Edderic/air-cleaners/laminair/diy/diy.md

# DIY Installation

## Printing Steps

### General Settings

| | MK4 | MK3S+ |
| - | - | - |
|**Print Settings**| 0.20mm STRUCTURAL | 0.30 mm DRAFT mode |
|**Filament**| Generic PETG | Generic PETG |
|**Printer**| Original Prusa MK4 Input Shaper 0.4 nozzle | Original Prusa i3 MK3S & MK3S+ |
|**Supports**| None | None |

### STL information

| Link to file | Infill |
| - | - |
| [top_left.stl](../stl_files/top_left.stl)| 25% |
| [top_right.stl](../stl_files/top_right.stl)| 25% |
| [bottom_left.stl](../stl_files/bottom_left.stl)| 25% |
| [bottom_right.stl](../stl_files/bottom_right.stl)| 25% |
| [elbow.stl](../stl_files/elbow.stl)| 25% |
| [stand.stl](../stl_files/stand.stl)| 50% |
| [power_switch.stl](../stl_files/power_switch.stl)| 25% |

## Assembly Steps

- [Assembling the main body](./assembling-main-body.md)
- [Installing the handle](./installing-the-handle.md)
- [Installing the fans and the swivel](./installing-fans-and-swivel.md)
- [Installing the power bank](./installing-power-bank.md)
- [Installing the stand](./installing-stand.md)
- [Installing the filters](./installing-filters.md)
