Edderic/air-cleaners/common/shoulder_strap_half_ring.3mf

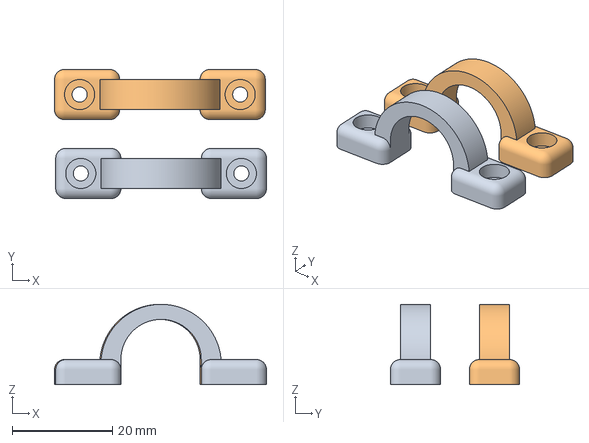
[picture p1: CAD file, 2023-08-09]
common/shoulder_strap_half_ring.3mf
42.2 x 25.7 x 16.0 mm
shoulder_strap_half_ring.stl x 2
