Edderic/air-cleaners/cr_boxes/handle.3mf

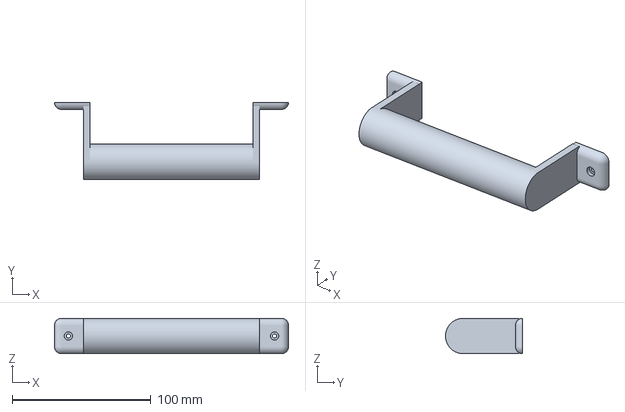
[picture p2: CAD file, 2023-10-18]
cr_boxes/handle.3mf
168.4 x 55.4 x 25.4 mm
