Edderic/air-cleaners/cr_boxes/three_by_three/bottom_right.3mf

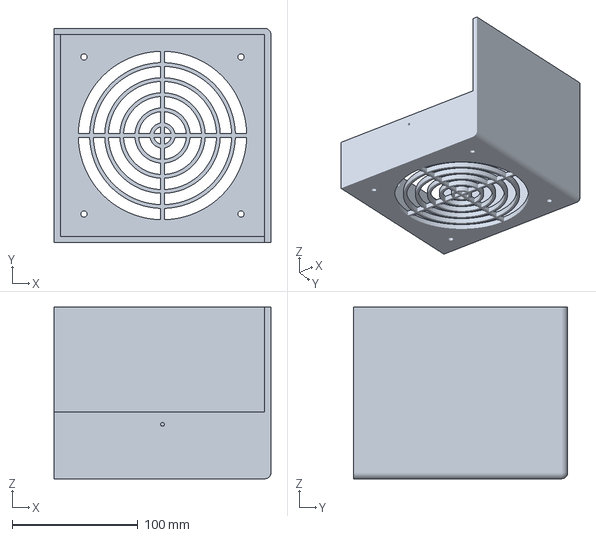
[picture p3: CAD file, 2023-10-16]
cr_boxes/three_by_three/bottom_right.3mf
172.7 x 170.6 x 136.5 mm
