Edderic/air-cleaners/laminair/3mf_files/top_right.3mf

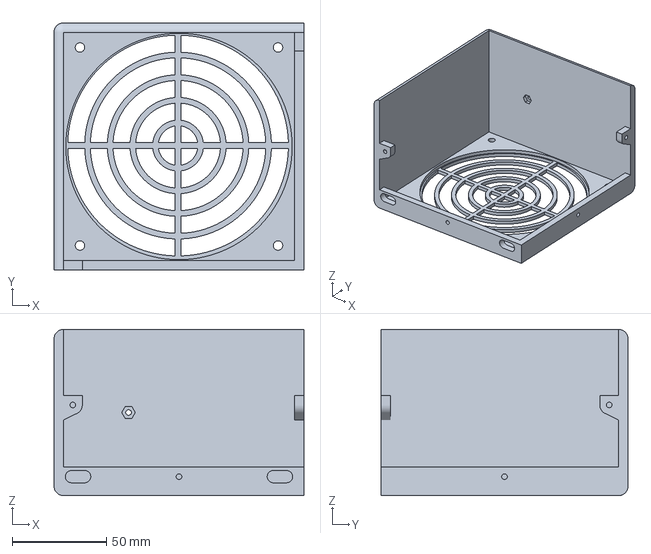
[picture p4: CAD file, 2024-10-20]
laminair/3mf_files/top_right.3mf
132.5 x 131.0 x 88.0 mm
