Edderic/air-cleaners/misc/probe_stand.3mf

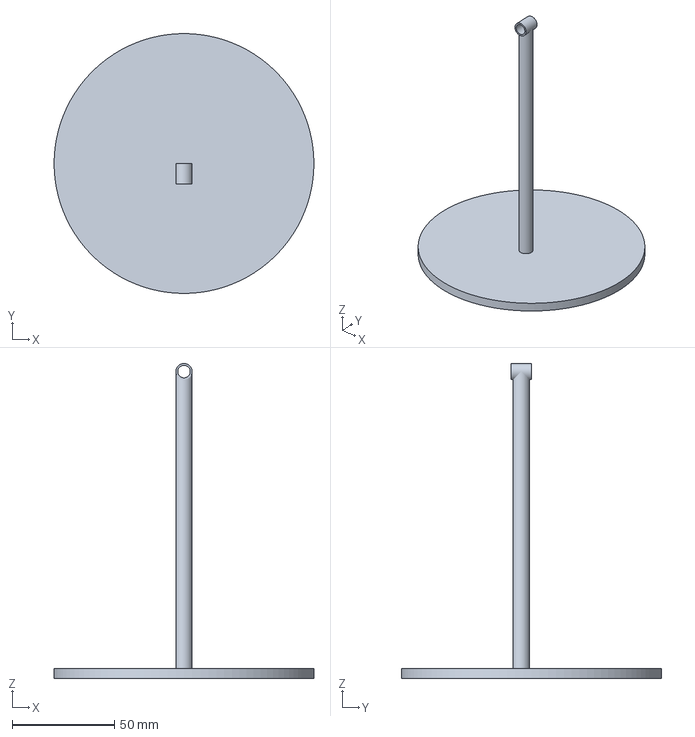
[picture p5: CAD file, 2024-10-07]
misc/probe_stand.3mf
127.0 x 127.0 x 154.0 mm
