Edderic/air-cleaners/cr_boxes/corners.3mf

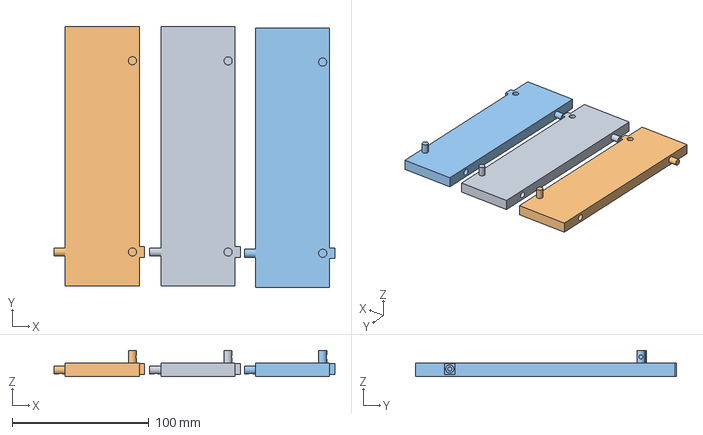
[picture p6: CAD file, 2023-10-07]
cr_boxes/corners.3mf
205.7 x 191.0 x 19.1 mm
corner.stl x 3
