Edderic/air-cleaners/misc/sps30_holder_with_wedge.3mf

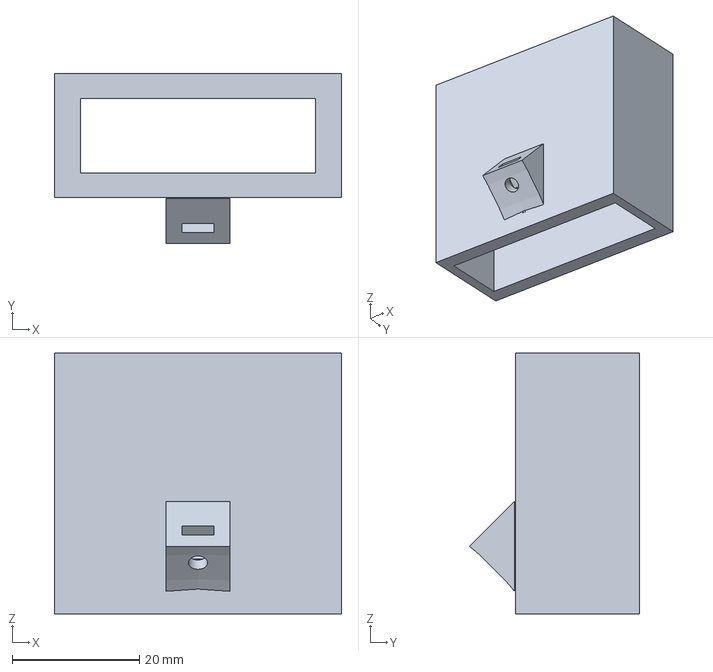
[picture p8: CAD file, 2023-11-09]
misc/sps30_holder_with_wedge.3mf
45.1 x 26.7 x 41.0 mm
