Edderic/air-cleaners/cr_boxes/vertical_wall_1_with_hole.3mf

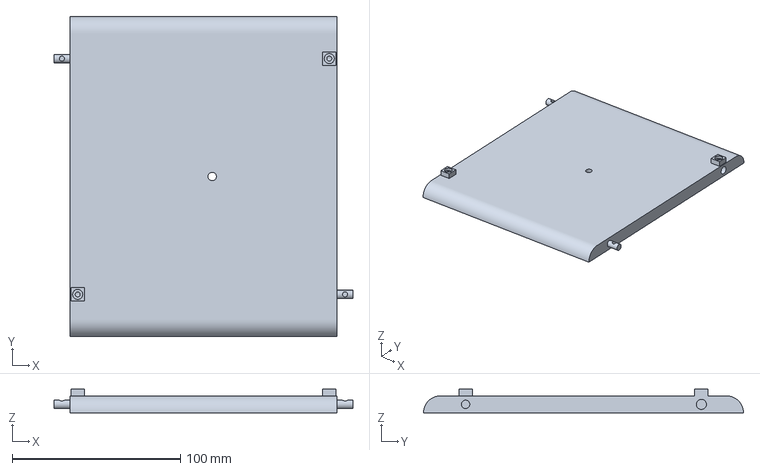
[picture p9: CAD file, 2023-10-07]
cr_boxes/vertical_wall_1_with_hole.3mf
177.5 x 190.0 x 14.0 mm
