Edderic/air-cleaners/laminair/3mf_files/power_switch_mk3s_plus.3mf

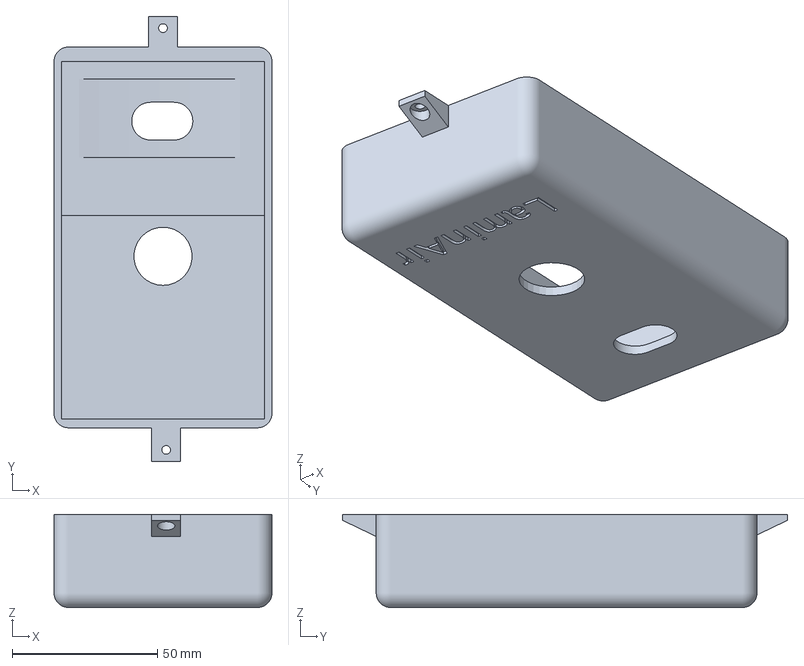
[picture p10: CAD file, 2024-10-20]
laminair/3mf_files/power_switch_mk3s_plus.3mf
75.0 x 153.1 x 32.0 mm
