Edderic/air-cleaners/misc/head_support.3mf

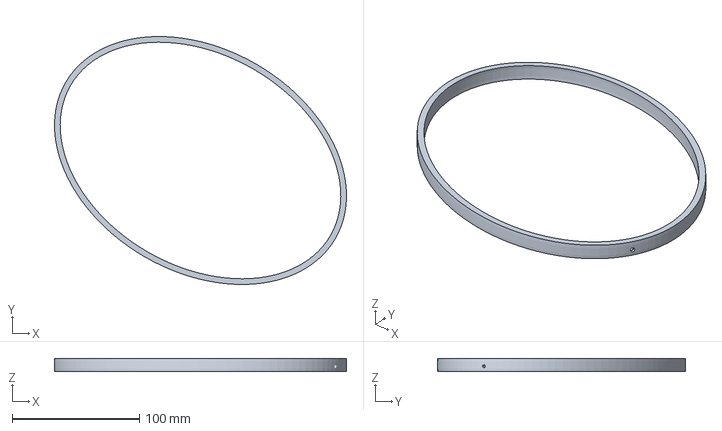
[picture p11: CAD file, 2023-10-18]
misc/head_support.3mf
229.4 x 194.8 x 10.0 mm
