Edderic/air-cleaners/laminair/3mf_files/elbow_mk3s_plus.3mf

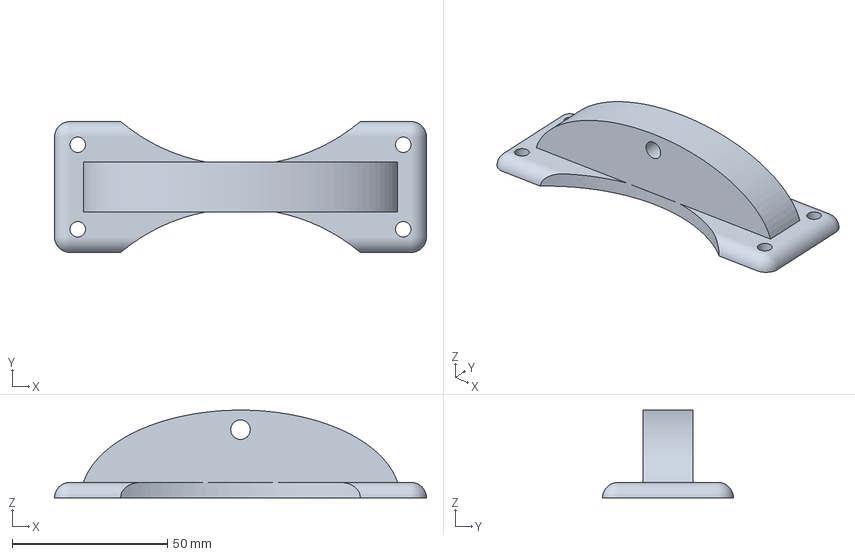
[picture p12: CAD file, 2024-10-20]
laminair/3mf_files/elbow_mk3s_plus.3mf
120.0 x 42.2 x 28.3 mm
