Edderic/air-cleaners/cr_boxes/row_fan.3mf

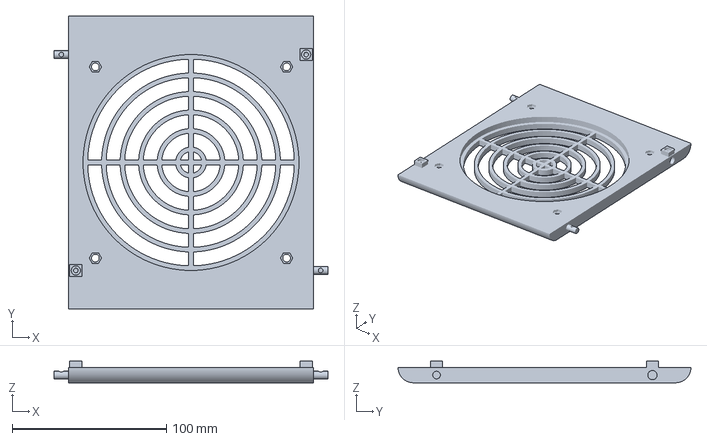
[picture p13: CAD file, 2023-10-04]
cr_boxes/row_fan.3mf
177.5 x 190.0 x 14.0 mm
