Edderic/air-cleaners/cr_boxes/corner.stl

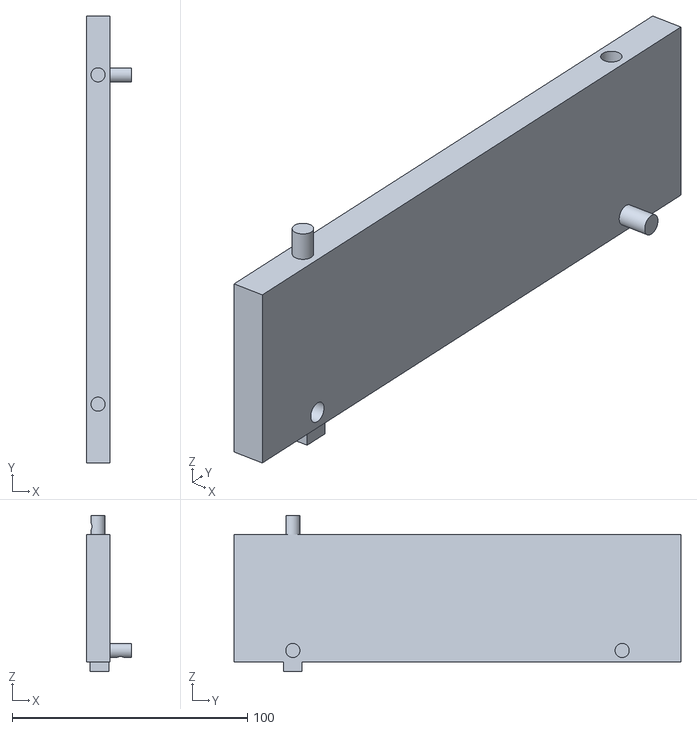
[picture p14: CAD file, 2023-10-04]
cr_boxes/corner.stl
19.1 x 190.0 x 66.4
