Edderic/air-cleaners/laminair/3mf_files/stand_mk3s_plus.3mf

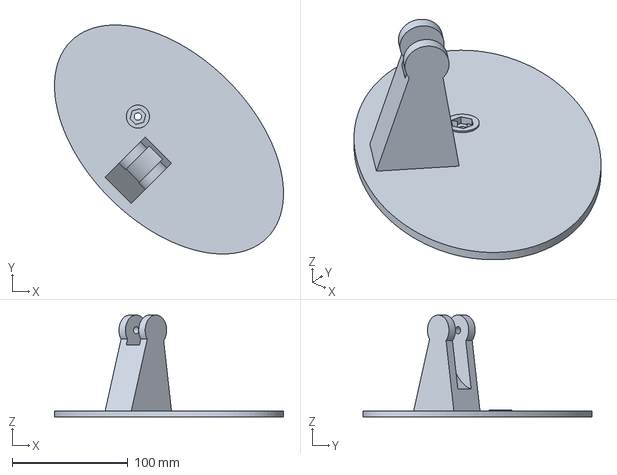
[picture p15: CAD file, 2024-10-20]
laminair/3mf_files/stand_mk3s_plus.3mf
197.8 x 197.8 x 88.1 mm
