Edderic/air-cleaners/laminair/3mf_files/power_switch_2.3mf

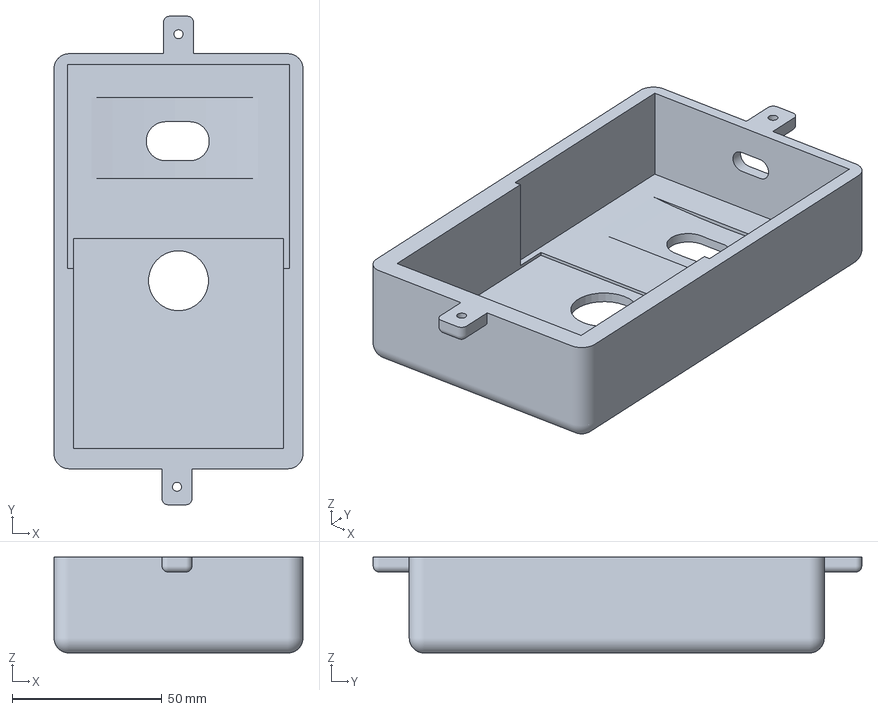
[picture p16: CAD file, 2023-12-02]
laminair/3mf_files/power_switch_2.3mf
83.0 x 162.9 x 32.0 mm
