Edderic/air-cleaners/common/fan.scad

use <hex_nut.scad>
$fn = 100;

// | 70
// |
// |
// |
// |        62.5
// -------------

module fan(
    radius,
    depth,
    screw_radius,
    multiplier = 70 - 7.5
) {
  _distance_to_middle_of_circle_x = radius == 60 ? 52.5 : multiplier / 70 * radius;
  _distance_to_middle_of_circle_y = radius == 60 ? 52.5 : multiplier / 70 * radius;

  linear_extrude(height=depth) circle(radius);
  // top right corner
  translate([_distance_to_middle_of_circle_x, _distance_to_middle_of_circle_y, 0]) {
    linear_extrude(height=depth) circle(screw_radius);
  }

  // bottom left corner
  translate([-_distance_to_middle_of_circle_x, -_distance_to_middle_of_circle_y, 0]) {
    linear_extrude(height=depth) circle(screw_radius);
  }

  // bottom right corner
  translate([_distance_to_middle_of_circle_x, -_distance_to_middle_of_circle_y, 0]) {
    linear_extrude(height=depth) circle(screw_radius);
  }

  // top left corner
  translate([-_distance_to_middle_of_circle_x, _distance_to_middle_of_circle_y, 0]) {
    linear_extrude(height=depth) circle(screw_radius);
  }

  // hex nut 1
  translate([_distance_to_middle_of_circle_x, _distance_to_middle_of_circle_y, depth - 2]) {
    hex_nut(4);
  }

  // hex nut 2
  translate([-_distance_to_middle_of_circle_x, -_distance_to_middle_of_circle_y, depth - 2]) {
    hex_nut(4);
  }

  // hex nut 3
  translate([_distance_to_middle_of_circle_x, -_distance_to_middle_of_circle_y, depth - 2]) {
    hex_nut(4);
  }

  // hex nut 4
  translate([-_distance_to_middle_of_circle_x, _distance_to_middle_of_circle_y, depth - 2]) {
    hex_nut(4);
  }
}

fan(radius=60, depth=5, distance_to_middle_of_circle_x=62/70 * 60, distance_to_middle_of_circle_y=62/70 * 60);
