Edderic/air-cleaners/cr_boxes/vertical_wall_2_with_hole.scad

use <builder.scad>

vertical_wall(with_handle=true, row_wall_index=1);
