Edderic/air-cleaners/laminair/bottom_right.scad

use <../cr_boxes/three_by_three/fan_container.scad>
use <shoulder_strap_half_ring_left.scad>
use <fan_filter.scad>
use <methods.scad>

depth = get_wall_depth();

// SmartAir S
filter_x = get_filter_dim()[0];
filter_y = get_filter_dim()[1];
filter_z = get_filter_dim()[2];
grid_z=get_grid_z();
num_fan_rows = get_num_fan_enclosure_dim()[0];
num_fan_cols = get_num_fan_enclosure_dim()[1];
width = get_fan_enclosure_width();
length = get_fan_enclosure_length();
fan_diameter = get_fan_diameter();

x_spacing = get_fan_to_wall_spacing_dim()[0];
y_spacing = get_fan_to_wall_spacing_dim()[1];
z_spacing = get_fan_to_wall_spacing_dim()[2];

module bottom_right(
  width,
  length,
  filter_x,
  filter_y,
  filter_z,
  grid_z,
  x_spacing,
  y_spacing,
  z_spacing,
  fan_diameter
) {
  difference() {
    translate([width / 2, -length / 2,0]) {
      fan_container(
          fan_size=120,
          x_spacing=x_spacing,
          y_spacing=y_spacing,
          z_spacing=z_spacing,
          z_offset=20,
          width=width,
          length=length,
          filter_z=filter_z,
          filter_x=filter_x,
          filter_y=filter_y,
          z=grid_z,
          left_front_edge_smoothed=true,
          bottom_left_front_corner_smoothed=true,
          bottom_right_corner_smoothed=true,
          bottom_front_edge_smoothed=true,
          edge_fan_bottom_smoothed=true,
          edge_fan_right_smoothed=true,
          edge_bottom_right_smoothed=true,
          top_screw_hole=true,
          left_screw_hole=true,
          bottom_screw_hole=false,
          right_screw_hole=false,
          long_wall="bottom-right",
          bottom_right_stabilizer="p2",
          bottom_right_stabilizer_axis="horizontal",
          top_left_stabilizer="p1",
          top_left_stabilizer_axis="vertical",
          top_left_zip_tie_hole=true,
          top_right_zip_tie_hole=true
        );
    }
  }
}


bottom_right(
  width,
  length,
  filter_x,
  filter_y,
  filter_z,
  grid_z,
  x_spacing,
  y_spacing,
  z_spacing,
  fan_diameter
);
