Edderic/air-cleaners/laminair/top_left.scad

use <../cr_boxes/three_by_three/fan_container.scad>
use <fan_filter.scad>
use <filter_louvers_container.scad>
use <methods.scad>
use <power_switch.scad>
use <../common/flexible_handle.scad>

depth = get_wall_depth();

filter_x = get_filter_dim()[0];
filter_y = get_filter_dim()[1];
filter_z = get_filter_dim()[2];
grid_z=get_grid_z();
num_fan_rows = get_num_fan_enclosure_dim()[0];
num_fan_cols = get_num_fan_enclosure_dim()[1];
width = get_fan_enclosure_width();
length = get_fan_enclosure_length();
fan_diameter = get_fan_diameter();

x_spacing = get_fan_to_wall_spacing_dim()[0];
y_spacing = get_fan_to_wall_spacing_dim()[1];
z_spacing = get_fan_to_wall_spacing_dim()[2];


module top_left(
  width,
  length,
  filter_x,
  filter_y,
  filter_z,
  grid_z,
  x_spacing,
  y_spacing,
  z_spacing,
  fan_size
) {
  difference() {
    translate([-width / 2, length / 2,0]) {
      fan_container(
          fan_size=120,
          filter_x=filter_x,
          filter_y=filter_y,
          filter_z=filter_z,
          z=grid_z,
          grid_z=grid_z,
          x_spacing=x_spacing,
          y_spacing=y_spacing,
          z_spacing=z_spacing,
          z_offset=20,
          top_left_corner_smoothed=true,
          bottom_left_corner_smoothed=false,
          bottom_right_corner_smoothed=false,
          bottom_right_front_corner_smoothed=false,
          top_front_edge_smoothed=true,
          top_right_corner_smoothed=false,
          top_right_front_corner_smoothed=true,
          edge_fan_top_smoothed=true,
          edge_fan_bottom_smoothed=false,
          edge_fan_right_smoothed=false,
          edge_fan_left_smoothed=true,
          edge_top_left_smoothed=true,
          edge_top_right_smoothed=false,
          edge_bottom_left_smoothed=false,
          edge_bottom_right_smoothed=false,
          right_front_edge_smoothed=true,
          bottom_right_zip_tie_hole=true,
          bottom_left_zip_tie_hole=true,
          top_screw_hole=false,
          left_screw_hole=false,
          bottom_screw_hole=true,
          right_screw_hole=true,
          long_wall="top-left",
          width=width,
          length=length,
          top_left_stabilizer="p1",
          top_left_stabilizer_axis="horizontal",
          bottom_right_stabilizer="p2",
          bottom_right_stabilizer_axis="vertical"
        );
    }
    union() {
      power_switch_screw_top();
      flexible_handle_for_laminair(fan_size, filter_y, depth, filter_z, grid_z);
    }
  }
}


top_left(
  width,
  length,
  filter_x,
  filter_y,
  filter_z,
  grid_z,
  x_spacing,
  y_spacing,
  z_spacing,
  fan_diameter
);
