Edderic/air-cleaners/misc/sps30.scad

function get_sps30_dims() = [41, 13, 41];

module sps30() {
  cube(get_sps30_dims(), center=true);
}
