Edderic/air-cleaners/(list of files, cad)

Other CAD files:
laminair/3mf_files/top_left.3mf
cr_boxes/three_by_three/right.3mf
cr_boxes/three_by_three/top.3mf
cr_boxes/vertical_wall_2_with_hole.3mf
laminair/3mf_files/bottom_right_mk3s_plus.3mf
cr_boxes/row_wall.3mf
cr_boxes/three_by_three/bottom.3mf
cr_boxes/three_by_three/top_left.3mf
laminair/3mf_files/top_left_mk3s_plus.3mf
cr_boxes/three_by_three/left.3mf
laminair/3mf_files/top_right_mk3s_plus.3mf
cr_boxes/three_by_three/center.3mf
cr_boxes/three_by_three/bottom_left.3mf
laminair/3mf_files/bottom_left_mk3s_plus.3mf
laminair/3mf_files/stand.3mf
laminair/3mf_files/bottom_right.3mf
laminair/3mf_files/bottom_left.3mf
laminair/3mf_files/elbow.3mf
laminair/3mf_files/power_switch.3mf
common/nut.scad
laminair/top_right.scad
cr_boxes/three_by_three/bottom_left.scad
cr_boxes/three_by_three/bottom_right.scad
cr_boxes/three_by_three/center.scad
cr_boxes/three_by_three/left.scad
cr_boxes/three_by_three/right.scad
cr_boxes/three_by_three/top_left.scad
cr_boxes/three_by_three/top_right.scad
common/shoulder_strap_half_ring.stl
cr_boxes/handle.stl
cr_boxes/row_fan.stl
cr_boxes/row_wall.stl
cr_boxes/three_by_three/bottom.stl
cr_boxes/three_by_three/bottom_left.stl
cr_boxes/three_by_three/bottom_right.stl
cr_boxes/three_by_three/center.stl
cr_boxes/three_by_three/left.stl
cr_boxes/three_by_three/right.stl
cr_boxes/three_by_three/top.stl
cr_boxes/three_by_three/top_left.stl
cr_boxes/three_by_three/top_right.stl
cr_boxes/vertical_wall_1_with_hole.stl
cr_boxes/vertical_wall_2_with_hole.stl
laminair/stl_files/bottom_left.stl
laminair/stl_files/bottom_right.stl
laminair/stl_files/elbow.stl
laminair/stl_files/power_switch.stl
laminair/stl_files/stand.stl
laminair/stl_files/top_left.stl
laminair/stl_files/top_right.stl
misc/head_support.stl
misc/probe_stand.stl
misc/sps30_holder_with_wedge.stl
