Edderic/air-cleaners/laminair/diy/assembling-main-body.md

# DIY

## Assembling the main body

### What's needed

| Item | Amount | Link | Notes |
| - | - | - |- |
| M3x8mm hex head screw | 8 | [link](https://www.amazon.com/gp/product/B01MCW5GM3/ref=ewc_pr_img_1?smid=A30WUG2ZDGM0XM&psc=1) |
| M3x8mm hex nut | 8 |  [link](https://www.amazon.com/gp/product/B08N68W9SP/ref=ppx_yo_dt_b_search_asin_title?ie=UTF8&th=1) |
| top_left.stl | 1 | [link](./laminair/top_left.stl) |
| top_right.stl | 1 | [link](./laminair/top_right.stl) |
| bottom_left.stl | 1 | [link](./laminair/bottom_left.stl) |
| bottom_right.stl | 1 | [link](./laminair/bottom_right.stl) |

Arrange the 4 main parts like so:


There should be two holes in red. That will be used for the handle later on. Also notice the two blue holes on the right. Those will be used for the container for the power bank & power switch.

Using an **M3x8mm hex screw**, screw the top left and bottom left pieces together.



Before going all the way, make sure to add the **M3 nut** at the bottom. Continue screwing until the two feel secure.



Do the same thing for this section next:



Next, we work on connecting the bottom pieces togetherc



Insert the **M3 hex nut** before fully tightening:



The power switch has a **male** end and a **female** end. The **female** end should be in the main body, while the **male** end along with the **power switch** should be outside the main body. Insert the wire between the **female** end and the power switch into the groove of the bottom right part:



A more close-up view:



Complete the main body:



Use **M3x8mm** screws and nuts to secure the main body:







[Go back to DIY page](./diy.md)
[Next up: Installing the handle](./installing-the-handle.md)
