Edderic/air-cleaners/laminair/diy/installing-fans-and-swivel.md

# DIY

## Installing the fans and swivel

### What's needed

| Item | Amount | Link |
| - | - | - |
| Assembled main body with handle from the previous step | 1 | [link](./installing-the-handle.md) |
| M4x35mm screws | 12 | [link](https://www.amazon.com/cSeao-M4x35mm-Machine-Phillips-Stainless/dp/B08R8K2QSW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) |
| M4x40mm screws | 4 | [link](https://www.amazon.com/gp/product/B06Y1YCSB8/ref=ppx_yo_dt_b_search_asin_title?ie=UTF8&psc=1) |
| M4 nylon insert lock nuts | 16 | [link](https://www.amazon.com/M4-0-7-Nylon-Insert-Stainless-100pcs/dp/B0BHQMBRFX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) |
| Philips Screw Driver | 1 |  [link](https://www.amazon.com/Screwdriver-Industrial-Strength-Klein-Tools/dp/B0015SBILG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) |
| Needle-nose Pliers | 1 |  [link](https://www.amazon.com/CRAFTSMAN-CMHT81645-Long-Nose-Pliers/dp/B08PFK8YWQ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) |
| ARCTIC P12 120mm fans| 4 |  [link](https://www.amazon.com/dp/B07HC782D5?ref=ppx_yo2ov_dt_b_product_details&th=1) |
| CRJ Full Speed 12V Voltage Step-Up USB to 3-Pin and 4-Pin PC Fan Sleeved Power Adapter Cable | 1 |  [link](https://www.amazon.com/dp/B07QFG6LFR?psc=1&ref=ppx_yo2ov_dt_b_product_details) |

### Steps

Insert a **120mm fan** to the bottom left section like so:


Insert a **M4x35mm** screw into the holes **farthest away from the center of the main body**:



Screw in the **M4 lock nut**:


Use the **needle-nose pliers** to hold the **M4 lock nut** in place while you screw:


Repeat the same steps for the other screw hole, and then insert the other bottom fan:


Repeat the screwing procedure with the **M4x40mm screws** and **M4 lock nuts**.



Have the main body have the intake section be facing up. Place the swivel on top of the bottom layer of fan containers, and line up the screw holes with the bottom:



Using **M4x40mm** screws, secure the **swivel** to the main body:


Flip the LaminAir over, add the **M4 lock nuts**, then tightend them using the **needle-nose pliers** and the **philips screw driver**:


Insert the other 2 fans, and secure them to the **main body** via 8 **M4x35mm** screws and 8 **M4 lock nuts**.


Get the **CRJ 12V USB-to-4-pin**. Connect the USB male end of that to the female end of the **ELECTOP power switch**:


Daisy chain the fans to each other, and have one of the fans connect to the **CRJ 12V USB-to-4-pin**:


Use velcro or cable ties to tidy up the wiring:



[Go back to DIY page](./diy.md)
[Next up: Installing the power bank](./installing-power-bank.md)
