Edderic/air-cleaners/laminair/diy/installing-power-bank.md

# DIY

## Installing the power bank

### What's needed

| Item | Amount | Link |
| - | - | - |
| Assembled main body with handle and fans from the previous step | 1 | [link](./installing-fans-and-swivel.md) |
| power_switch.stl| 1 | [link](./power_switch.stl) |
| M3x8mm hex head screw | 2 | [link](https://www.amazon.com/gp/product/B01MCW5GM3/ref=ewc_pr_img_1?smid=A30WUG2ZDGM0XM&psc=1) |
| M3x8mm hex nut | 2 |  [link](https://www.amazon.com/gp/product/B08N68W9SP/ref=ppx_yo_dt_b_search_asin_title?ie=UTF8&th=1) |
| UseBean Right Angle USB C Extension Cable | 1 |  [link](https://www.amazon.com/gp/product/B08F7BSG24/ref=ppx_yo_dt_b_search_asin_title?ie=UTF8&psc=1) |
| 2.5mm hex wrench | 1 |  [link](https://www.amazon.com/HORUSDY-Wrench-Metric-30-Piece-0-7mm-10mm/dp/B075BZGJJK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) |

### Steps

Get the `power_switch`:


Using the **2.5mm hex wrench**, make sure the holes for the screws are not obstructed:



Get the the **UseBean Right Angle USB C Extension Cable**.

Screw in the **M4 lock nut**:


Insert the wider USB-C end into the top hole. It will be tight. Wiggle it in to make room for it.




Remove the USB-C end from the power switch container, and then insert the power switch into the corresponding hole:


Insert the wider USB-C end into the top hole again, while the power switch is in the correct position:


Get the power bank:



Plug the USB male of the power switch into the power bank:


Remove the plastic from the other end of the **USB C extension cable**:


Connect the other end of the **USB C extension cable** into the power bank, like so:


Reposition:


Add **M3x8mm** screws to the top and bottom screw holes:



Connect the power bank container to the main body. Screw to tighten, while also
adding **M3 hex nuts** for a more secure connection.


Tighten:


[Go back to DIY page](./diy.md)
[Next up: Installing the stand](./installing-stand.md)
