Edderic/air-cleaners/laminair/diy/installing-stand.md

# DIY

## Installing the stand

### What's needed

| Item | Amount | Link |
| - | - | - |
| Assembled main body with handle, fans, power bank from the previous step | 1 | [link](./installing-power-bank.md) |
| stand.stl| 1 | [link](./stand.stl) |
| flange nuts| 2 | [link](https://www.amazon.com/gp/product/B00L1LBFPQ/ref=ppx_yo_dt_b_search_asin_title?ie=UTF8&psc=1) |
| M3x8mm hex nut | 2 |  [link](https://www.amazon.com/gp/product/B08N68W9SP/ref=ppx_yo_dt_b_search_asin_title?ie=UTF8&th=1) |
| 4-point stud knobs | 1 |  [link](https://www.amazon.com/dp/B091DQ53BJ?ref=ppx_yo2ov_dt_b_fed_asin_title) |

### Steps

Get the relevant materials:


Turn the main body so that you could see the hole for the swivel is pointing up.  Align the holes:


Start screwing in the stud knob from the other side. Stop when the screw part of the stud knob is about to come out:


Add the **flange nut**:


Using your thumb, hold down the **flange nut** while tigtening via the **stud knob**.


Other side should look something like this:


[Go back to DIY page](./diy.md)
[Next up: Installing the filters](./installing-filters.md)
