Edderic/air-cleaners/laminair/diy/installing-the-handle.md

# DIY

## Installing the handle

### What's needed

| Item | Amount | Link | Notes |
| - | - | - |- |
| Assembled main body from the previous step | 1 | [link](./assembling-main-body.md) |
| M3x8mm hex head screw | 2 | [link](https://www.amazon.com/gp/product/B01MCW5GM3/ref=ewc_pr_img_1?smid=A30WUG2ZDGM0XM&psc=1) |
| M3x8mm hex nut | 2 |  [link](https://www.amazon.com/gp/product/B08N68W9SP/ref=ppx_yo_dt_b_search_asin_title?ie=UTF8&th=1) |
| Reliable Hardware Company RH-0570BK-2-A Strap Handle Set | 1 |  [link](https://www.amazon.com/dp/B00JJ190AW?ref=ppx_yo2ov_dt_b_product_details&th=1) |
| Washer | 2 |  [link](https://www.amazon.com/dp/B00JJ190AW?ref=ppx_yo2ov_dt_b_product_details&th=1) |

### Steps

Set the main body so the two holes for the straps are at the top:


Place the **handle** on the top of the main body:


Place a **washer** near one of the two holes:


Using the **M3 hex wrench**, wiggle the **washer** so that it's in between the rubber and the metal part:



Insert the **M3x8mm hex screw** and start screwing it in:


When half-way done, insert the **M3 hex nut** on the other side:


Screw as tight as possible:


Now do the same steps for the other side:


You will have to push the loose end of the handle to make a curve so that the screw is perpendicular to the main body.This might be a little challenging. You will have to hold this position while also screwing the **M3x8mm** screw:



Add the **M3 hex** to the remaining hole and then continue screwing to tighten the connection between the handle and the main body:


Tighten as much as possible:


[Go back to DIY page](./diy.md)
[Next up: Installing the fans and the swivel](./installing-fans-and-swivel.md)
