Edderic/air-cleaners/laminair/diy/installing-filters.md

# DIY

## Installing the filters

### What's needed

| Item | Amount | Link |
| - | - | - |
| Assembled main body with handle, fans, power bank, stand from the previous step | 1 | [link](./installing-stand.md) |
| Honeywell HHT270 HEPA| 2 | [link](https://www.amazon.com/gp/product/B00KQGTORS/ref=ppx_yo_dt_b_search_asin_title?ie=UTF8&psc=1) |
| thin double-sided tape|  | [link](https://www.amazon.com/Adhesive-Transparent-Scrapbook-Woodworker-Clothing/dp/B09796HRLR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) |

### Steps

Get one of the filters and place them like so


Add double sided tape:


Cut off the extra tape:


Connect the two filters:



Make sure the two black little pieces are sticking out in the middle (and not sticking to the double sided tape):


Insert the two combined filters, with the white side facing out:


Push them in so that they fit snugly with the main body.
