Edderic/air-cleaners/(threads)

Thread 1 (2024-01-29):

Printables missing files

Starblade42, 2024-01-29:
Printables is missing at least these two files:
1. battery_fan_enclosure.stl
2. louver.stl

I also think the `louver_sync` information is missing from the `README.md`. I'm not sure if there's more that's missing from Printables, but I expect all that's needed is in this repo?

Thread 2 (2024-01-29):

Possible simplified CAD files for a Prusa XL printer?

Starblade42, 2024-01-29:
It looks like a lot of the assembly has to be cut up to make it work on smaller printers, which is awesome!

But the Prusa XL has a  which has 36×36×36 cm print volume. The Prusa XL can print objects the size of the finalized Laminair. This means the *Fan Housing could be one piece* with all four fan openings, and the *Louver Holder could be one piece* instead of 4.

Having CAD files designed to be printed on the Prusa XL would make a final assembly that is:

- Prettier
- Simpler to assemble
- more durable

Could the Prusa XL print the whole Louver Assembly *in place?* (probably not given that we want the louvers to be nice and smooth). In actual fact the louver holder might need to be two pieces, or one with a split at one end and a nut and bolt to allow the piece to flexed to install the louvers and the louver sync.

So, if that's a TRIVIAL task, it would be lovely to have.

I don't have a 3d printer, so I haven't done CAD in a long while, but it's also probably not too much work to fuse those things myself and remove the nut/bolt connector parts.

Starblade42, 2024-04-04:
If I had more experience with these tools and printers and the like, I'd actually be able to have a feel for if this is like 30 minutes of work, or a LOT more. (If it was trivial, and I had the skills, I would have opened a PR instead).

It's an idea, and if it's not trivial to execute OR you just don't feel like it will be useful to you, feel free to close this issue. We can already print your design on a Prusa XL as is, which is still exciting.

Thank you!

Edderic, 2024-04-17:
Hey @Starblade42 ,

Thanks for the suggestions! Yeah I think this is easily doable. I have one OpenSCAD file here that pulls in many components so I can have a more global view in designing the LaminAir. I could just create new OpenSCAD files for the louver housing, for the main body, and remove the screws that way, and then export STL. The only drawback I can think of would be:

* Prusa XL printers are usually more expensive than a regular one, which means less people who have existing 3D printers can print it
* If a part breaks, you'll have to re-print a larger piece that you otherwise wouldn't have to with the original design.

I think for the regular design, I can experiment hiding the "joints" so that it looks cleaner.

Are you thinking of purchasing a Prusa XL at some point?

P.S. I hope you're enjoying your 1st LaminAir! I know the 2nd one is still in transit.

Starblade42, 2024-04-18:
It's truly a thing of beauty. You've really got your extruders dialed in! And the power bank you chose is lovely too. I really like the charging readout.
One thought: I wish that the louver holders on each side had a little nubbin or something to help me adjust the louvres up and down. I can use a fingernail to press on the top or bottom of the louvre holders end, but it takes a bit of more concentration.
