Edderic/air-cleaners/(commit log)

2023-06-03 personal air cleaner part 1
    [personal-air-cleaner.scad]
2023-06-05 handle 1 QT3 filter
    [pac-p1.scad]
2023-06-06 smaller 2-filter design
    [pac-p1.scad]
2023-06-15 wip doing 2 filter, 2 fan design
    [fan.scad, filler-1-filter.3mf, filler-1-filter.stl, filler.scad, hex_nut.scad, left_side_and_right_side.scad, louver-2-filter.3mf, louver-2-filter.stl]
2023-06-30 noctua speed controller
    [noctua_speed_controller.scad]
2023-07-05 smoothen edges
    [one_filter_one_fan_battery_casing.scad]
2023-07-14 implement smoothed cube
    [smoothed_cube.scad]
2023-07-15 smoothed cube
    [main_no_side_holes.scad, smoothed_cube.scad]
2023-08-09 wip airgowear
    [back_cover.scad, battery_door.3mf, battery_door.scad, battery_door.stl, battery_door_switch_screws.scad, battery_door_with_switch.3mf, battery_door_with_switch.scad, battery_door_with_switch.stl]
2023-08-10 wip: airgowear exterior
    [back_cover.scad, body.scad, body.stl, epa_long.3mf, noctua_speed_controller.scad, smoothed_cube.scad]
2023-08-22 model filter_enclosure with 2D points
    [filter_enclosure.scad]
2023-08-22 remove 2D points of filter enclosure
    [filter_enclosure.scad]
2023-08-23 wip: create airgo-ff
    [body.scad, fan_holders.scad, fan_holders.stl, filter.scad, filter_bed_points.csv, filter_enclosure.scad, filterbase.3mf, hex_nut.scad]
2023-09-07 add tubing
    [tube_connector.scad, tube_connector.stl]
2023-09-07 add airgo_qt3
    [air_expander.3mf, air_expander.scad, air_expander.stl, battery_fan_enclosure.3mf, battery_fan_enclosure.scad, battery_fan_enclosure.stl, body.scad, body.stl]
2023-09-07 add threaded_height parameter
    [shoulder_strap_half_ring.scad, shoulder_strap_support_screws.scad]
2023-09-16 tcore_powerbank with taller hole
    [tcore_powerbank.scad]
2023-09-16 add nut_type argument
    [body.scad]
2023-09-18 nut_type hex
    [shoulder_strap_half_ring.scad, shoulder_strap_support_screws.scad]
2023-09-18 implement small diffuser
    [small_diffuser.scad]
2023-09-20 wip: working on curvy filter section
    [battery_fan_belt_clipon.3mf, clavicle_screw_holes.scad, clavicle_support.scad, diffuser.scad, filter_section.scad, filter_section.stl, small_diffuser.3mf, small_diffuser.stl]
2023-09-22 experiment with thicker bands for integrity
    [tube_connector.scad]
2023-09-22 new setting
    [tube_connector.scad]
2023-09-23 add rectangle wheel for grip
    [tube_connector.scad]
2023-09-23 render stl for tube_connector
    [tube_connector.stl]
2023-09-23 add nut offset to make holes
    [nut.scad]
2023-09-23 use offset to make holes
    [screw_with_nut.scad]
2023-09-23 extract tubing
    [diffuser.scad, tubing.scad]
2023-09-23 experimentation with axial fan. Probably not gonna happen
    [body.scad]
2023-09-23 filter_section first try
    [filter_section.scad]
2023-09-23 render filter_section
    [filter_section.stl]
2023-09-23 prusaslicer save of filter_section
    [filter_section.3mf]
2023-09-23 extract local_tubing, and reuse
    [filter_section.scad]
2023-09-23 move filter_box back so that there are no holes in two corners
    - removes accidental holes
    [filter_section.scad]
2023-09-23 make the back part longer so that the nose will be more in the middle
    [filter_section.scad]
2023-09-25 maintain constant height for cylindrical diffuser
    [cylindrical_diffuser.scad]
2023-09-25 make cylindrical_diffuser screwable
    [cylindrical_diffuser.scad, cylindrical_diffuser.stl]
2023-09-25 use threaded height, update z of local_tubing
    [filter_section.scad]
2023-09-30 row_fan with correct orientation
    [builder.scad, row_fan.scad, row_fan.stl]
2023-09-30 flip the orientation so that screws go inward
    [row_fan.scad, row_fan.stl]
2023-10-04 cr boxes
    [builder.scad, corner.scad, corner.stl, row_fan.3mf, row_fan.scad, row_wall.3mf, row_wall.stl]
2023-10-07 finish version 1 of pc-fan based air cleaner
    [builder.scad, corners.3mf, handle.3mf, handle.scad, handle.stl, vertical_wall_1_with_hole.3mf, vertical_wall_1_with_hole.scad, vertical_wall_1_with_hole.stl]
2023-10-07 diffuser screws for airgo tubed
    [diffuser_screws.scad]
2023-10-07 cylindrical diffuser prusaslicer file
    [cylindrical_diffuser.3mf]
2023-10-07 tube_connector prusaslicer
    [tube_connector.3mf]
2023-10-07 filter_section stl
    [filter_section.stl]
2023-10-07 add default to fan.scad
    [fan.scad]
2023-10-07 create walls to hold screws
    [fan_container.scad]
2023-10-09 add bottom screw and top screw holes
    [fan_container.scad]
2023-10-09 customizable top, bottom, left, right screws
    [fan_container.scad]
2023-10-09 customizable top/left/right/bottom edge radius
    [fan_container.scad, row_fan.scad]
2023-10-09 wip: ignoring unknown module "top_spaced"
    [fan_container.scad, row_fan.scad]
2023-10-10 fixed hole & screws removal for fan
    [builder.scad, fan_container.scad, row_fan.scad]
2023-10-10 smooth out edges: top-left, top-right, bottom-left, bottom-right
    [fan_container.scad, row_fan.scad]
2023-10-10 extend the walls to hold filter
    [fan_container.scad, row_fan.scad]
2023-10-10 customizable wall length
    [fan_container.scad, row_fan.scad]
2023-10-14 create top-left, left, bottom-left, bottom, center, top
    [bottom.3mf, bottom.scad, bottom.stl, bottom_left.3mf, bottom_left.scad, bottom_left.stl, center.3mf, center.scad]
2023-10-14 head_support and sps30_holder_with_wedge
    [head_support.scad, sps30.scad]
2023-10-14 fix vertex 4 to 8 edge
    [smoothed_cube.scad]
2023-10-16 top right
    [top_right.scad, top_right.stl]
2023-10-16 prusaslicer top
    [top.3mf]
2023-10-16 adjust edge_4_8 so that the corner isn't mising
    [smoothed_cube.scad]
2023-10-16 implement other three_by_three subparts
    [bottom_right.3mf, bottom_right.scad, bottom_right.stl, right.3mf, right.scad, right.stl, top_right.3mf]
2023-10-16 add more spacing between fan screws
    [fan.scad]
2023-10-18 make handle shorter
    [handle.3mf, handle.scad, handle.stl]
2023-10-18 head support too long
    [head_support.3mf, head_support.scad, head_support.stl]
2023-11-09 create 4 PC-fan pieces
    [fan_filter.scad]
2023-11-09 misc head support and sps30 holder
    [head_support.scad, sps30_holder_with_wedge.3mf, sps30_holder_with_wedge.scad, sps30_holder_with_wedge.stl]
2023-11-09 make screws appear correctly when modifying filter size
    [fan_container.scad]
2023-11-09 successfully position finger guards
    [fan_container.scad, fan_filter.scad, row_fan.scad]
2023-11-09 extract top_right piece into its own module / file
    [fan_filter.scad, top_right.scad]
2023-11-10 tweak laminair for SmartAir S
    [fan_container.scad, fan_filter.scad, row_fan.scad, top_right.scad, top_right.stl]
2023-11-10 add powerbank
    [fan_filter.scad]
2023-11-10 smoothing; modify shoulder_strap_half_ring screws offset
    [fan_filter.scad, shoulder_strap_half_ring_left.scad, top_left.scad]
2023-11-11 add power_switch and battery attachment stuff
    [fan_filter.scad]
2023-11-13 add get_tcore_powerbank_z
    [tcore_powerbank.scad]
2023-11-13 get_switch_x and get_switch_y
    [switch.scad]
2023-11-13 laminair bottom_left
    [bottom_left.3mf, bottom_left.scad, bottom_left.stl]
2023-11-13 remove extra spacing between fan grill and body
    [fan_container.scad]
2023-11-13 maybe not needed
    [shoulder_strap_half_ring.scad, shoulder_strap_half_ring_left.scad, shoulder_strap_support_screws.scad]
2023-11-13 thinner profile
    [power_switch.scad]
2023-11-24 extract methods
    [methods.scad]
2023-11-24 wip: add filter container and space to hold louvers
    [filter_louvers_container.scad]
2023-11-25 wip: add louvers
    [filter_louvers_container.scad]
2023-11-29 save working louvers
    [louver.scad, louver.stl, louver_rad_2.stl, louver_sync.3mf, louver_sync.scad, louver_sync.stl, louver_sync_0.3_rad_offset.stl, louvers.3mf]
2023-11-29 height_offset as argument
    [filter_louvers_container.scad]
2023-11-29 remove holes for louvers in x and y planes
    [filter_louvers_container.scad]
2023-11-29 use get_wall_depth
    [power_switch.scad]
2023-11-30 thicker shoulder strap half ring. Hopefully it won't break due to pressure'
    [shoulder_strap_half_ring.scad, shoulder_strap_half_ring.stl]
2023-11-30 refactor, add default for arguments
    [fan_container.scad]
2023-11-30 make screws even
    [fan_container.scad]
2023-11-30 make filter_z bigger to retain the depth of the outer walls
    [methods.scad]
2023-11-30 decrease grid_z to make space for wiring
    [methods.scad]
2023-11-30 fan holes for laminair showing up again
    [builder.scad, methods.scad, row_fan.scad]
2023-11-30 increase filter z to ensure all of the filter goes in
    [fan_container.scad, methods.scad, top_left.scad]
2023-11-30 correct placement of battery attachment screw
    [fan_filter.scad]
2023-12-01 bottom-left grid_z shortened
    [bottom_left.scad]
2023-12-01 show bottom left
    [fan_filter.scad]
2023-12-01 power_switch looks nice again
    [power_switch.scad]
2023-12-01 make the walls deeper so that filter doesn't get smooshed
    [methods.scad]
2023-12-01 show fan holes again
    [methods.scad, row_fan.scad]
2023-12-01 add holes for zip ties
    [fan_container.scad]
2023-12-01 add holes to bottom_left and top_left
    [bottom_left.scad, top_left.scad]
2023-12-01 fix attachment screw
    [top_left.scad]
2023-12-01 add zip-tie holes and make z longer so filter isn't squished
    [top_left.stl]
2023-12-02 realign tcore_powerbank and switch
    [methods.scad, power_switch.scad]
2023-12-02 wider power switch
    [power_switch.scad, power_switch.stl]
2023-12-02 fix distance between battery_attachments
    [power_switch.3mf, power_switch.scad, power_switch.stl, power_switch_2.3mf]
2023-12-02 top_left
    - improve durability
    - move powerswitch down
    [top_left.3mf, top_left.scad, top_left.stl]
2023-12-02 use stabilizersr for top_left
    [top_left.3mf, top_left.scad]
2023-12-02 top_right
    - add stabilizers
    - larger spacing to ensure filter doesn't get squished
    [top_right.3mf, top_right.scad, top_right.stl]
2023-12-02 use module
    [fan_container.scad]
2023-12-02 ensure zip hole is full
    [fan_container.scad]
2023-12-03 top_left_stabilizer vertical for bottom_right.scad
    [bottom_right.scad, fan_container.scad, fan_filter.scad, filter_louvers_container.scad, shoulder_strap_half_ring.scad, tcore_powerbank.scad, top_left.scad, usbc_female.scad]
2023-12-03 fix screw holes, add stabilizers
    [fan_container.scad]
2023-12-04 add stabilizer functionality
    [fan_container.scad]
2023-12-04 cone code
    [fan_container.scad]
2023-12-04 use stabilizers
    [top_left.scad, top_right.scad]
2023-12-04 3mf and stl
    [fan_filter.scad, power_switch.3mf, shoulder_strap_half_rings.3mf, top_right.3mf, top_right.stl]
2023-12-04 add feet capability
    [fan_container.scad]
2023-12-04 add screw holes for feet for bottom_right
    [bottom_right.scad, fan_container.scad]
2023-12-05 handle adding horizontal p1
    [fan_container.scad]
2023-12-05 stabilizer code for bottom_left
    [fan_container.scad]
2023-12-05 add stabilizers properly to bottom_left and bottom_right
    [bottom_left.3mf, bottom_left.scad, bottom_left.stl, bottom_left_filter_p2.scad, bottom_left_filter_p2.stl, bottom_right.3mf, bottom_right.scad, bottom_right.stl]
2023-12-05 add stabilizers
    [top_left.3mf, top_left.scad, top_left.stl]
2023-12-05 top_right prusa slicer
    [top_right.3mf]
2023-12-06 show filter_louvers_container
    [fan_filter.scad]
2023-12-06 display screw joins correctly for filter_louvers_container
    [filter_louvers_container.scad]
2023-12-07 split out filter_louver_container into 4 parts
    [filter_louvers_container.3mf, filter_louvers_container.scad, filter_louvers_container_p1.scad, filter_louvers_container_p1.stl, filter_louvers_container_p2.scad, filter_louvers_container_p2.stl, filter_louvers_container_p3.scad, filter_louvers_container_p3.stl]
2023-12-07 add feet, extracted
    [foot.3mf, foot.scad, foot.stl]
2023-12-08 air curtain prototype
    [all.3mf, all.scad, all.stl, outlet.stl, outlet_smaller_middle_hole.3mf, outlet_smaller_middle_hole.stl]
2023-12-12 attempt to make the filter_louver_container fit the main body
    [filter_louvers_container.scad]
2023-12-12 try to increase friction so that the louver sync stays in place
    - limit the effect of gravity
    [filter_louvers_container.scad]
2023-12-12 import foot correctly
    [fan_container.scad]
2023-12-12 import flexible_handle
    [fan_filter.scad]
2023-12-12 create some spacing for the screw join
    [power_switch.scad]
2023-12-12 make holes for the handle
    [top_left.scad, top_right.scad]
2023-12-13 was too tight
    [filter_louvers_container.scad, top_left.3mf, top_left.stl]
2023-12-13 add spacing between finger guard and fan blades
    [bottom_left.3mf, bottom_left.stl, bottom_right.3mf, bottom_right.stl, top_left.3mf, top_right.3mf, top_right.stl]
2023-12-13 make the louver-to-container bond stronger by elongating the louver
    [filter_louvers_container.scad, louver.scad]
2023-12-13 realign the body of the louver with the cylinders
    [filter_louvers_container.scad]
2023-12-13 finger_guard can take in depth
    [fan_container.scad, row_fan.scad]
2023-12-13 modify z of louvers relative to the louver container
    [filter_louvers_container.scad]
2023-12-13 add cone.scad
    [cone.scad]
2023-12-13 add flexible_handle.scad
    [flexible_handle.scad]
2023-12-13 stl files
    [filter_louvers_container_p1.stl, filter_louvers_container_p2.stl, filter_louvers_container_p3.stl, filter_louvers_container_p4.stl, louver.stl, louver_sync.stl, power_switch.stl]
2023-12-13 rm test.scad and test.stl
    [test.scad, test.stl]
2023-12-13 rm test2
    [test2.scad, test2.stl]
2023-12-29 fix alignment of fan hole and finger guard
    [fan_container.scad]
2023-12-29 deeper screw for foot
    - so that we can have a nut for bottom_left and bottom_right
    [foot.3mf, foot.scad, foot.stl]
2023-12-29 fix spacing between screws that hold the fan.
    - at least for 120mm fans
    [fan.scad]
2023-12-31 wiring hole closer to the fan grill
    - make space for filter
    [bottom_left.3mf, bottom_left.scad, bottom_left.stl]
2023-12-31 fan grill centering
    [bottom_right.3mf, bottom_right.stl]
2023-12-31 fan grill centering and screw holes
    [top_left.3mf, top_left.stl]
2023-12-31 top_right fix centering of fan guard
    [top_right.3mf, top_right.stl]
2024-01-02 Try 0.21875 addition to radius hole.
    - still too tight
    [filter_louvers_container.3mf, filter_louvers_container.scad, filter_louvers_container_p1.stl, filter_louvers_container_p2.stl, filter_louvers_container_p3.stl, filter_louvers_container_p4.stl, louver.stl]
2024-01-02 use larger hole
    [filter_louvers_container.3mf, filter_louvers_container.scad, filter_louvers_container_p1.stl, filter_louvers_container_p2.stl, filter_louvers_container_p3.stl, filter_louvers_container_p4.stl]
2024-01-04 try larger radius offset
    [filter_louvers_container.3mf, filter_louvers_container.scad, filter_louvers_container_p1.stl, filter_louvers_container_p2.stl, filter_louvers_container_p3.stl, filter_louvers_container_p4.stl, louver.scad]
2024-01-04 experimental hole to save printing costs
    [louver_hole.3mf, louver_hole.scad, louver_hole.stl]
2024-01-04 decrease friction even more so louvers could be usable
    [filter_louvers_container.scad]
2024-01-05 3mf stl bigger hole, less friction
    [filter_louvers_container.3mf, filter_louvers_container_p1.stl, filter_louvers_container_p2.stl, filter_louvers_container_p3.stl, filter_louvers_container_p4.stl, louver_hole.3mf]
2024-01-10 remove airgo_axial
    [body.scad]
2024-01-10 remove airgo_tubed
    [battery_fan_belt_clipon.3mf, battery_fan_belt_clipon.scad, battery_fan_belt_clipon.stl, clavicle_screw_holes.scad, clavicle_support.scad, cylindrical_diffuser.3mf, cylindrical_diffuser.scad, cylindrical_diffuser.stl]
2024-01-10 remove all_together.scad and two_filter_one_fan_all_together.scad
    [all_together.scad, two_filter_one_fan_all_together.scad]
2024-01-10 remove back_cover.scad and two_filter_back_cover.scad
    [back_cover.scad, two_filter_back_cover.scad]
2024-01-10 remove battery_casing_left
    [battery_casing_left.3mf, battery_casing_left.scad, battery_casing_left.stl]
2024-01-10 remove battery_door and switch_support
    [battery_door.3mf, battery_door.scad, battery_door.stl, battery_door_and_switch_support.3mf, battery_door_switch_screws.scad, battery_door_with_switch.3mf, battery_door_with_switch.scad, battery_door_with_switch.stl]
2024-01-10 remove c_clamp*
    [c_clamp_f.3mf, c_clamp_f.scad, c_clamp_f.stl, c_clamp_m.3mf, c_clamp_m.scad, c_clamp_m.stl, c_clamp_nuts_holder.3mf, c_clamp_nuts_holder.scad]
2024-01-10 remove two_filter*
    [two_filter_back_cover.3mf, two_filter_back_cover.stl, two_filter_casing_enclosure.scad, two_filter_casing_enclosure_p2.3mf, two_filter_casing_enclosure_p2.scad, two_filter_casing_enclosure_p2.stl, two_filter_left_side.3mf, two_filter_left_side.scad]
2024-01-10 remove pac-*
    [pac-2-filter-louver-casing.stl, pac-2-filter-louver-holder.3mf, pac-p1-1-filter.3mf, pac-p1-1-filter.stl, pac-p1-120mm.3mf, pac-p1-120mm.stl, pac-p1-2-filter.3mf, pac-p1-2-filter.stl]
2024-01-10 rm battery_casing*
    [battery_casing_right.3mf, battery_casing_right.scad, battery_casing_right.stl]
2024-01-10 remove filter_casing*
    [filter_casing_enclosure_left.3mf, filter_casing_enclosure_left.scad, filter_casing_enclosure_left.stl, filter_casing_enclosure_right.3mf, filter_casing_enclosure_right.scad, filter_casing_enclosure_right.stl]
2024-01-10 remove louver*
    [louver-2-filter.3mf, louver-2-filter.stl, louver-holder.3mf, louver-holder.stl, louver-mini-1-fan.3mf, louver-mini-1-fan.stl, louver-sync.3mf, louver-sync.stl]
2024-01-10 remove one_filter*
    [one_filter_one_fan_battery_casing.3mf, one_filter_one_fan_battery_casing.scad, one_filter_one_fan_battery_casing.stl, one_filter_one_fan_main.3mf, one_filter_one_fan_main.scad, one_filter_one_fan_main.stl]
2024-01-10 remove main*
    [main_a1.scad, main_no_side_holes.scad]
2024-01-10 remove test*
    [test_usbc_female.3mf, test_usbc_female.scad, test_usbc_female.stl]
2024-01-10 remove speed_controller_support*
    [speed_controller_support.3mf, speed_controller_support.scad, speed_controller_support.stl]
2024-01-10 remove personal-air-cleaner-p1*
    [personal-air-cleaner-p1.3mf, personal-air-cleaner-p1.stl]
2024-01-10 remove filler*
    [filler-1-filter.3mf, filler-1-filter.stl, filler.scad]
2024-01-10 remove two_*
    [two_120mm_two_qt3.scad, two_120mm_two_qt3.stl]
2024-01-10 remove top_*
    [top_mount.scad, top_screws_with_nuts.scad]
2024-01-10 remove slim_exterior*
    [slim_exterior.stl]
2024-01-10 remove left_*
    [left_side_and_right_side.scad]
2024-01-10 remove filter_bed_points.csv
    [filter_bed_points.csv]
2024-01-10 remove epa*
    [epa_adapter_edge.stl, epa_long.3mf, epa_long.scad, epa_long.stl]
2024-01-10 remove pac*
    [pac_p1.scad]
2024-01-10 remove side_holes*
    [side_holes.scad]
2024-01-10 remove switch_support.stl
    [switch_support.stl]
2024-01-10 remove back_cover.*
    [back_cover.3mf, back_cover.stl]
2024-01-10 usbc_female put into common folder
    [body.scad, fan_container.scad, fan_filter.scad, power_switch.scad, slimbody.scad, usbc_female.scad]
2024-01-10 remove filter_bed_points
2024-01-10 move screw_with_nut.scad and screw_with_hex_nut.scad to common
    [body.scad, builder.scad, fan_container.scad, fan_filter.scad, filter_louvers_container.scad, flexible_handle.scad, foot.scad, handle.scad]
2024-01-10 move to common
    [shoulder_strap_support_screws.scad]
2024-01-10 move noctua_speed_controller to common
    [body.scad, noctua_speed_controller.scad, slimbody.scad]
2024-01-10 remove hex_test
    [hex_test.scad, hex_test.stl]
2024-01-10 move smoothed_* to common
    [smoothed_corner.scad, smoothed_cube.scad, smoothed_edge.scad]
2024-01-10 move shoulder_strap_half_ring* to common
    [body.scad, fan_filter.scad, power_switch.scad, shoulder_strap_half_ring.3mf, shoulder_strap_half_ring.scad, shoulder_strap_half_ring.stl, shoulder_strap_half_ring_left.scad, shoulder_strap_half_rings.scad]
2024-01-10 remove unused
    [one_fan_one_filter_all_together.scad]
2024-01-10 move switch.scad to common
    [body.scad, fan_filter.scad, power_switch.scad, slimbody.scad, switch.scad]
2024-01-10 move tcore_powerbank to common
    [body.scad, fan_filter.scad, power_switch.scad, slimbody.scad, tcore_powerbank.scad]
2024-01-10 move flexible_handle.scad to common
    [fan_filter.scad, flexible_handle.scad, top_left.scad, top_right.scad]
2024-01-10 move fan.scad to common
    [builder.scad, fan.scad]
2024-01-11 add printing instructions
2024-01-11 assembly thumbnail
2024-01-17 remove unsude file
    [blah.scad]
2024-01-17 remove laminair/bottom_left_filter_p*
    [bottom_left_filter_p1.scad, bottom_left_filter_p1.stl, bottom_left_filter_p2.scad, bottom_left_filter_p2.stl]
2024-01-17 curvier handle
    [louver_sync.scad, louver_sync.stl, louver_sync_with_lever.3mf]
2024-01-17 bottom_left* and bottom_right* use 62.5% infill
    [bottom_left.3mf, bottom_right.3mf, top_left.3mf, top_right.3mf]
2024-01-17 larger hole to decrease friction, make it easier to move louvers in sync
    [louver_sync.scad, louver_sync.stl, louver_sync_with_lever.3mf]
2024-01-24 laminair: update bottom* and top* 3mf
    [bottom_left.3mf, bottom_right.3mf, top_left.3mf, top_right.3mf]
2024-01-24 add LaminAir logo
    [power_switch.3mf, power_switch.scad, power_switch.stl]
2024-03-18 show bottom-left and bottom-right
    [fan_filter.scad]
2024-03-18 hide power-switch for now
    [fan_filter.scad]
2024-03-18 use global vars for Starkvind. Switch fans to 140mm
    [methods.scad]
2024-03-18 fix spacing of holes for fan
    [row_fan.scad]
2024-03-18 use what's being passed in
    [builder.scad]
2024-03-18 remove wall first
    [fan_container.scad]
2024-03-18 use 120mm fans
    [methods.scad]
2024-03-18 fix top-left screw-join
    [fan_container.scad, methods.scad, power_switch.scad, top_left.scad]
2024-03-18 fix screw join for top-left
    [fan_container.scad]
2024-03-18 fix bottom left screw join spacing
    [bottom_left.scad, fan_container.scad]
2024-03-18 fix screw joins positioning for bottom_right
    [fan_container.scad]
2024-03-18 fix bottom_right screw_joins positioning
    [fan_container.scad, top_right.scad]
2024-03-18 fix flexible handle screw holes for top_right
    [flexible_handle.scad, top_right.scad]
2024-03-18 fix left_screw_and_nut for top_right
    [fan_container.scad, top_right.scad]
2024-03-18 [flexible-design] feet positioning adjusted based on filter size
    [fan_container.scad, fan_filter.scad, foot.scad, top_left.scad]
2024-03-18 [flexible-design] fix screw joins for filter_louvers_container
    [fan_container.scad, filter_louvers_container.scad]
2024-03-18 [flexible-design] permanent supports
    ...for main body and filter_louver_containers
    [fan_container.scad, filter_louvers_container.scad]
2024-03-18 [supports-unnecessary] power_switch no longer needs support
    [fan_filter.scad, methods.scad, power_switch.scad, shoulder_strap_half_ring.scad]
2024-03-18 [supports-unnecessary] 3mf, stl files
    [bottom_left.3mf, bottom_left.stl, bottom_right.3mf, bottom_right.stl, power_switch.scad, power_switch.stl, shoulder_strap_half_ring.scad, top_left.3mf]
2024-03-18 make it easier to put filter_louvers_container on
    [filter_louvers_container.scad, filter_louvers_container_p1.stl, filter_louvers_container_p2.stl, filter_louvers_container_p3.stl, filter_louvers_container_p4.stl]
2024-03-18 decrease wall enclosure depth.
    - simplify code
    - make it easier to push the filter_louvers_container into the main body
    [filter_louvers_container.scad]
2024-03-18 STL exports of filter louver container parts
    [filter_louvers_container_p1.stl, filter_louvers_container_p2.stl, filter_louvers_container_p3.stl, filter_louvers_container_p4.stl]
2024-03-18 increase wall depth to see if it will increase friction
    [filter_louvers_container.scad]
2024-03-18 stl files: thicker wall so hopefully the filter_louvers_container doesn't inadvertently fall out
    [filter_louvers_container_p1.stl, filter_louvers_container_p2.stl, filter_louvers_container_p3.stl, filter_louvers_container_p4.stl]
2024-03-18 3mf filter_louver_container
    [filter_louvers_container.3mf]
2024-03-18 decrease idle time - enough printing for nighttime
    [two_flc.3mf, two_ps_and_sshr.3mf]
2024-03-25 experiment with no-lever louver sync
    [louver_sync.scad, louver_sync_no_lever.3mf, louver_sync_no_lever.scad, louver_sync_no_lever.stl]
2024-03-26 attempt radius_offset=0.4
    [louver_sync.scad]
2024-03-26 tight enough, loose enough
    [louver_sync_no_lever.3mf, louver_sync_no_lever.stl]
2024-04-01 attempt wider louver_sync to get more friction
    [louver_sync.scad]
2024-04-01 still too loose. Increase friction
    [louver_sync.scad]
2024-04-01 add 3mf for MK4
    [bottom_left.3mf, bottom_right.3mf, filter_louvers_container_25perc_infill.3mf, louver_sync_no_lever.3mf, louvers.3mf, top_left.3mf, top_right.3mf, two_filter_louvers_container_25perc_infill.3mf]
2024-04-01 louver_sync_no_lever stl. Just right size
    [louver_sync_no_lever.stl]
2024-04-02 try even wider for increased friction
    [louver_sync.scad]
2024-04-02 try 5.125mm x_dim
    [louver_sync.scad]
2024-04-02 decrease x_dim, decrease radius_offset
    - see if we can get friction some other way
    [louver_sync.scad]
2024-04-03 try x_dim 4.875
    [louver_sync.scad]
2024-04-03 attempt tighter grip
    [louver_sync.scad, louver_sync_no_lever.3mf, louver_sync_no_lever.stl]
2024-04-03 not tight enough
    [louver_sync.scad]
2024-04-03 tighten up more
    [louver_sync.scad]
2024-05-28 add back louver-sync levers
    [louver_sync.scad, louver_sync.stl, louver_sync_no_lever.3mf, louver_sync_no_lever.stl, louver_sync_with_lever.3mf]
2024-09-20 remove filter louvers container from fan_filter
    [fan_filter.scad]
2024-09-20 remove shoulder strap half rings from top_right
    [top_right.scad]
2024-09-20 use honeywell filter
    [fan_container.scad, methods.scad]
2024-09-20 top_right top screw join is now in the right place
    [fan_container.scad]
2024-09-20 top_right bottom_left_stabilizer is now in the right place
    [fan_container.scad]
2024-09-20 top screw join for top_left is now in the right place
    [fan_container.scad, top_left.scad]
2024-09-20 remove shoulder strap half ring from top_left
    [top_left.scad]
2024-09-20 top_left bottom_right_stabilizer is now inside
    [fan_container.scad]
2024-09-20 moved top right screw joins to the right place for bottom_left
    [fan_container.scad]
2024-09-20 update stls
    [bottom_left.stl, top_right.stl]
2024-09-20 correct orientation for screw join for bottom_left. Remove feet
    [bottom_left.scad, fan_container.scad]
2024-09-20 bottom right stabilizer screw join is in the right place for bottom_right
    [bottom_right.scad, fan_container.scad]
2024-09-20 remove feet
    [bottom_right.scad]
2024-09-20 correct placement for bottom right stabilizer for bottom_right
    [bottom_right.scad, fan_container.scad]
2024-09-21 fix power switch screw holes positioning
    [fan_filter.scad, power_switch.scad]
2024-09-21 smooth out front edges for bottom_left
    [row_fan.scad]
2024-09-21 bottom left has nice curves in the front
    [bottom_left.scad, fan_container.scad, row_fan.scad, top_left.scad]
2024-09-21 top_left looks nice with curves in the front
    [fan_container.scad, row_fan.scad, top_left.scad]
2024-09-21 top left front has nice curves
    [row_fan.scad, top_left.scad]
2024-09-21 smooth out top left front corner of top_right
    [fan_container.scad, row_fan.scad, top_right.scad]
2024-09-21 add smoothed left edge in the front for top_right
    [row_fan.scad]
2024-09-21 export top_right
    [top_right.3mf]
2024-09-22 add smoothed corner for bottom_right
    [fan_container.scad, row_fan.scad]
2024-09-22 set edge radius to be dynamic
    [bottom_right.scad, methods.scad, row_fan.scad]
2024-09-22 add better demo
    [smoothed_cube.scad]
2024-09-22 fix bugs
    [fan_container.scad, row_fan.scad]
2024-09-22 add cad-query
2024-09-22 add 3mm to the length
    [methods.scad]
2024-09-22 stl and 3mf for adding 3mm
    [bottom_left.3mf, bottom_left.stl, bottom_right.3mf, bottom_right.stl, top_left.3mf, top_left.stl, top_right.3mf, top_right.stl]
2024-09-23 tighten up spacing so weather stripping not necessary
    [methods.scad, screw.scad]
2024-09-23 stl, 3mf, bgcode after removing 2mm
    [bottom_left.3mf, bottom_left.stl, bottom_right.3mf, bottom_right.stl, top_left.3mf, top_left.stl, top_right.3mf, top_right.stl]
2024-09-23 update top_left
    [top_left.3mf]
2024-09-23 laminair mk3s+ gcode and 3mf files
    [bottom_left_mk3s_plus.3mf, bottom_right_mk3s_plus.3mf, top_left_mk3s_plus.3mf, top_right_mk3s_plus.3mf]
2024-09-24 bottom right smoothed edge
    [bottom_right.3mf, bottom_right.scad, bottom_right.stl]
2024-09-24 update top_left, just in case
    [top_left.3mf, top_left.stl]
2024-09-24 smoothed edge for bottom_right mk3s+
    [bottom_right_mk3s_plus.3mf]
2024-09-24 top_left mk3s+
    [top_left_mk3s_plus.3mf]
2024-09-24 add outline of elbow
    [elbow.scad]
2024-09-24 elbow swivel
    [elbow.3mf, elbow.scad, elbow.stl]
2024-09-24 wip: structure to secure the body
    [elbow.scad, screw.scad, stand.scad]
2024-09-24 Add middle part of the stand
    [stand.scad]
2024-09-24 use correct spacing between screws
    [elbow.3mf, elbow.scad, elbow.stl]
2024-09-24 add base layer
    [elbow.scad, stand.scad]
2024-09-24 print out stand
    [stand.3mf, stand.scad, stand.stl]
2024-09-24 power switch for laminair v2. slightly smaller
    [power_switch.3mf, power_switch.stl]
2024-09-25 update stand to have larger hex nut
    [screw_knob.scad, stand.3mf, stand.scad, stand.stl]
2024-09-25 add more wall depth so parts are less flimsy
    [power_switch.3mf, power_switch.scad, power_switch.stl]
2024-09-25 update stand so that base is wider and the nut for tripod is under center of gravity, taking account the weight of the battery pack
    [stand.3mf, stand.scad, stand.stl]
2024-09-29 3mf, gcode for elbow, power switch, stand
    [elbow_mk3s_plus.3mf, power_switch_mk3s_plus.3mf, stand_mk3s_plus.3mf]
2024-09-29 switch to PETG
    [bottom_left.3mf, bottom_right.3mf, elbow.3mf, power_switch.3mf, stand.3mf, top_left.3mf, top_right.3mf]
2024-09-29 move screw_join by 0.5 mm
    [fan_container.scad, top_right.stl]
2024-09-29 slight modification to shoulder_strap_half_ring
    [shoulder_strap_half_ring.scad]
2024-10-06 add fit factor grid for laminair v2
    [LaminAir - v2 fit factor grid.csv]
2024-10-07 probe stand
    [probe_stand.3mf, probe_stand.scad, probe_stand.stl]
2024-10-09 update stand
    [screw_knob.scad, stand.3mf, stand.scad, stand.stl]
2024-10-20 mk3s_plus 3mf
    [bottom_left_mk3s_plus.3mf, bottom_right_mk3s_plus.3mf, elbow_mk3s_plus.3mf, power_switch_mk3s_plus.3mf, stand_mk3s_plus.3mf, top_left_mk3s_plus.3mf, top_right_mk3s_plus.3mf]
2024-10-20 update top_left and top_right
    [top_left.3mf, top_left.stl, top_right.3mf, top_right.stl]
2024-10-20 see spacing between top left and top right components
    [fan_filter.scad]
2024-10-20 remove airgo_air_curtain. unused
    [all.3mf, all.scad, all.stl, outlet.stl, outlet_smaller_middle_hole.3mf, outlet_smaller_middle_hole.stl]
2024-10-20 remove airgowear. unused
    [body.scad, body.stl, fan.scad, fan_holders.scad, fan_holders.stl, filter.scad, filterbase.3mf, holders.3mf]
2024-10-20 remove airgowear_ff. unused
    [battery_controls_casing.3mf, battery_controls_casing.scad, battery_controls_casing.stl, body.scad, elbow_screw_holders.3mf, elbow_screw_holders.scad, elbow_screw_holders.stl, filter.scad]
2024-10-20 remove airgo_qt3. unused
    [air_curtain.3mf, air_curtain.scad, air_curtain.stl, air_expander.3mf, air_expander.scad, air_expander.stl, battery_fan_enclosure.3mf, battery_fan_enclosure.scad]
2024-10-20 add screw instructions
2024-10-21 add last part of assembling main body
2024-10-21 installing the power bank
2024-10-21 add installing power bank
2024-10-21 remove louvers
    [louver.scad, louver.stl, louver_hole.3mf, louver_hole.scad, louver_hole.stl, louver_rad_2.stl, louver_sync.scad, louver_sync.stl]
2024-10-21 remove shoulder_strap_half_rings
    [shoulder_strap_half_ring.stl, shoulder_strap_half_ring_left.scad]
2024-10-21 remove filter_louvers_container
    [filter_louvers_container.3mf, filter_louvers_container.scad, filter_louvers_container_25perc_infill.3mf, filter_louvers_container_p1.scad, filter_louvers_container_p1.stl, filter_louvers_container_p2.scad, filter_louvers_container_p2.stl, filter_louvers_container_p3.scad]
2024-10-21 remove filter louvers container
    [two_filter_louvers_container_25perc_infill.3mf, two_flc.3mf]
2024-10-21 remove two_ps_and_sshr
    [two_ps_and_sshr.3mf]
2024-10-21 add instructions for adding the filters
2024-10-21 use correct # of filters
2024-10-21 add final image for filter addition
